Tim-Drake0/Flight-Computer/README.md

# Flight-Computer
Download and open bom.html for interactive BOM.

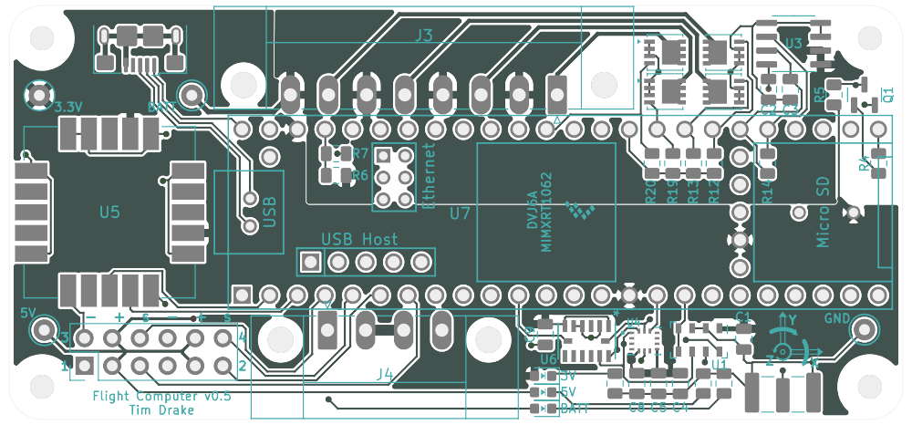
[picture p1: Pictures/v0.5.F.png]

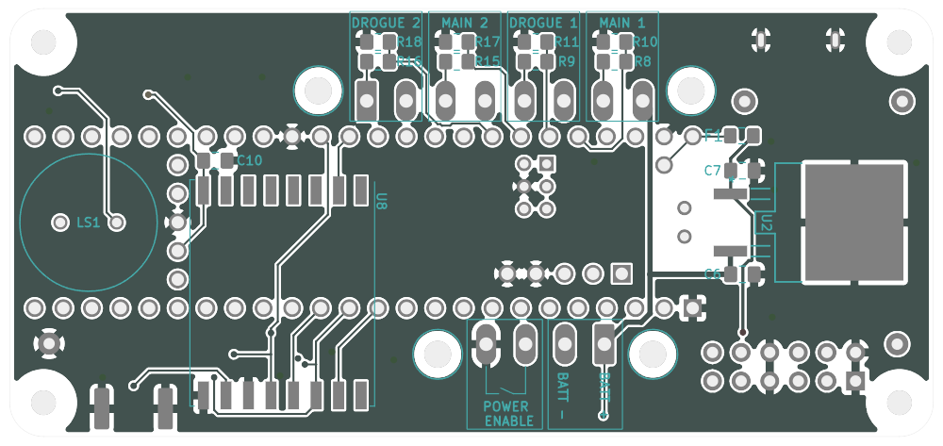
[picture p2: Pictures/v0.5.B.png]
