Tim-Drake0/Flight-Computer/v0.5.pdf

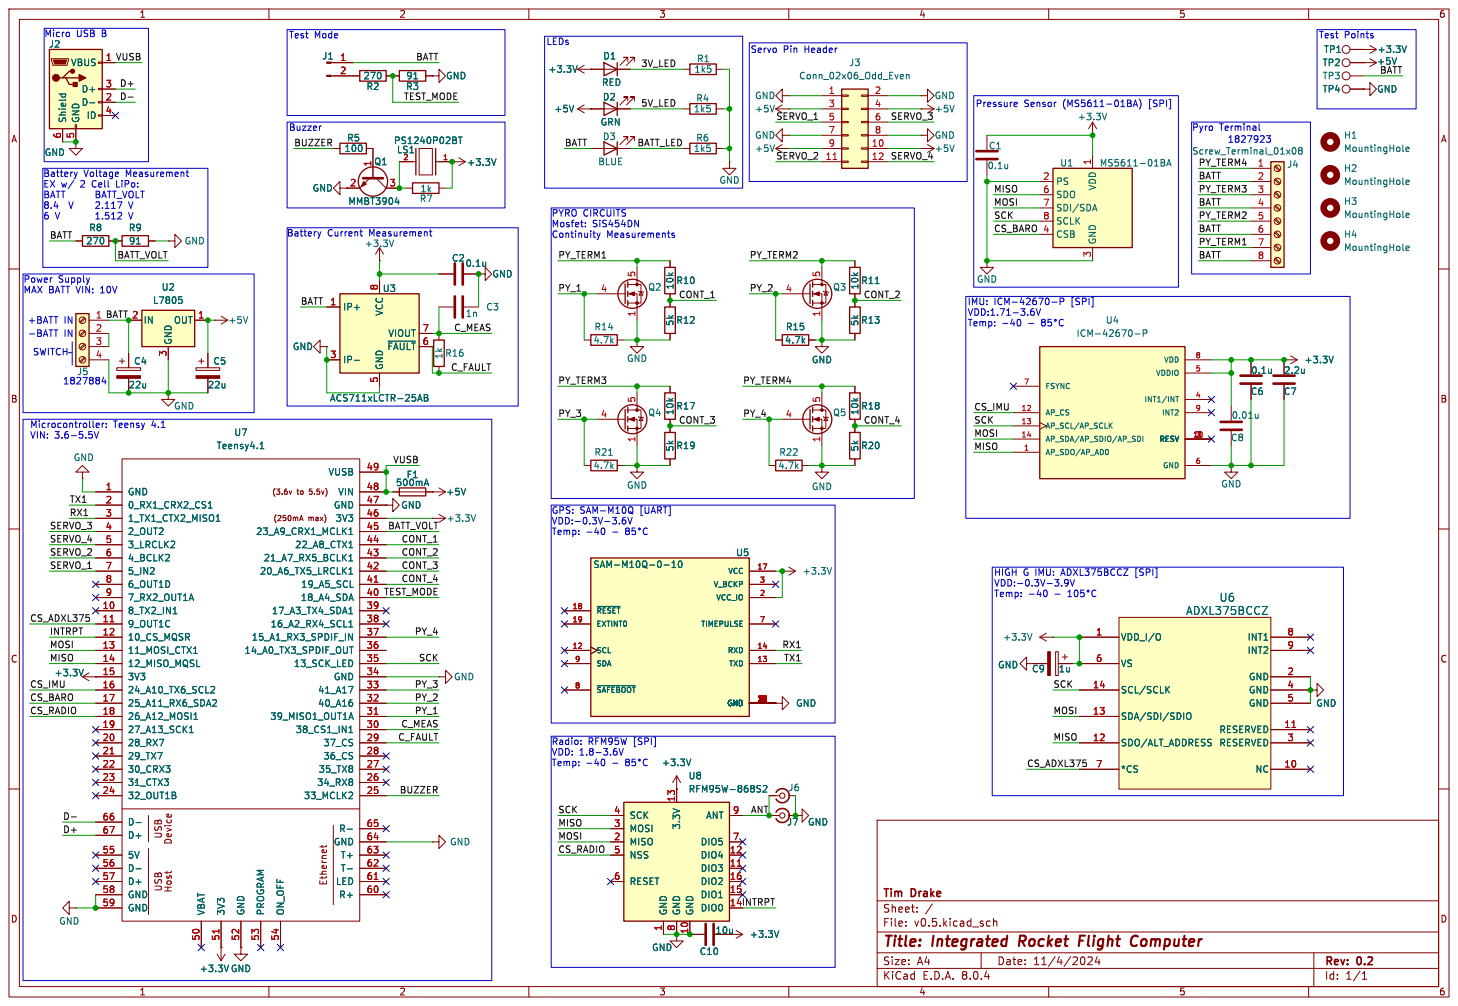
[picture p3: page 1]

Test Points PYRO CIRCUITS Mosfet: SiS454DN

3 CSB 4 SDO 6 SDI/SDA 7 SCLK 8 U1 MS5611-01BA GND

1827884 Power Supply MAX BATT VIN: 10V

1 GND 10 DIO3 11 DIO4 12 3.3V 13 DIO0 14 DIO1 15 DIO2 16 MISO 2 MOSI 3 SCK 4 NSS 5 RESET 6 DIO5 7 GND
