Tim-Drake0/Flight-Computer/v0.5.kicad_pcb

## KiCad design v0.5.kicad_pcb (2024-11-10)

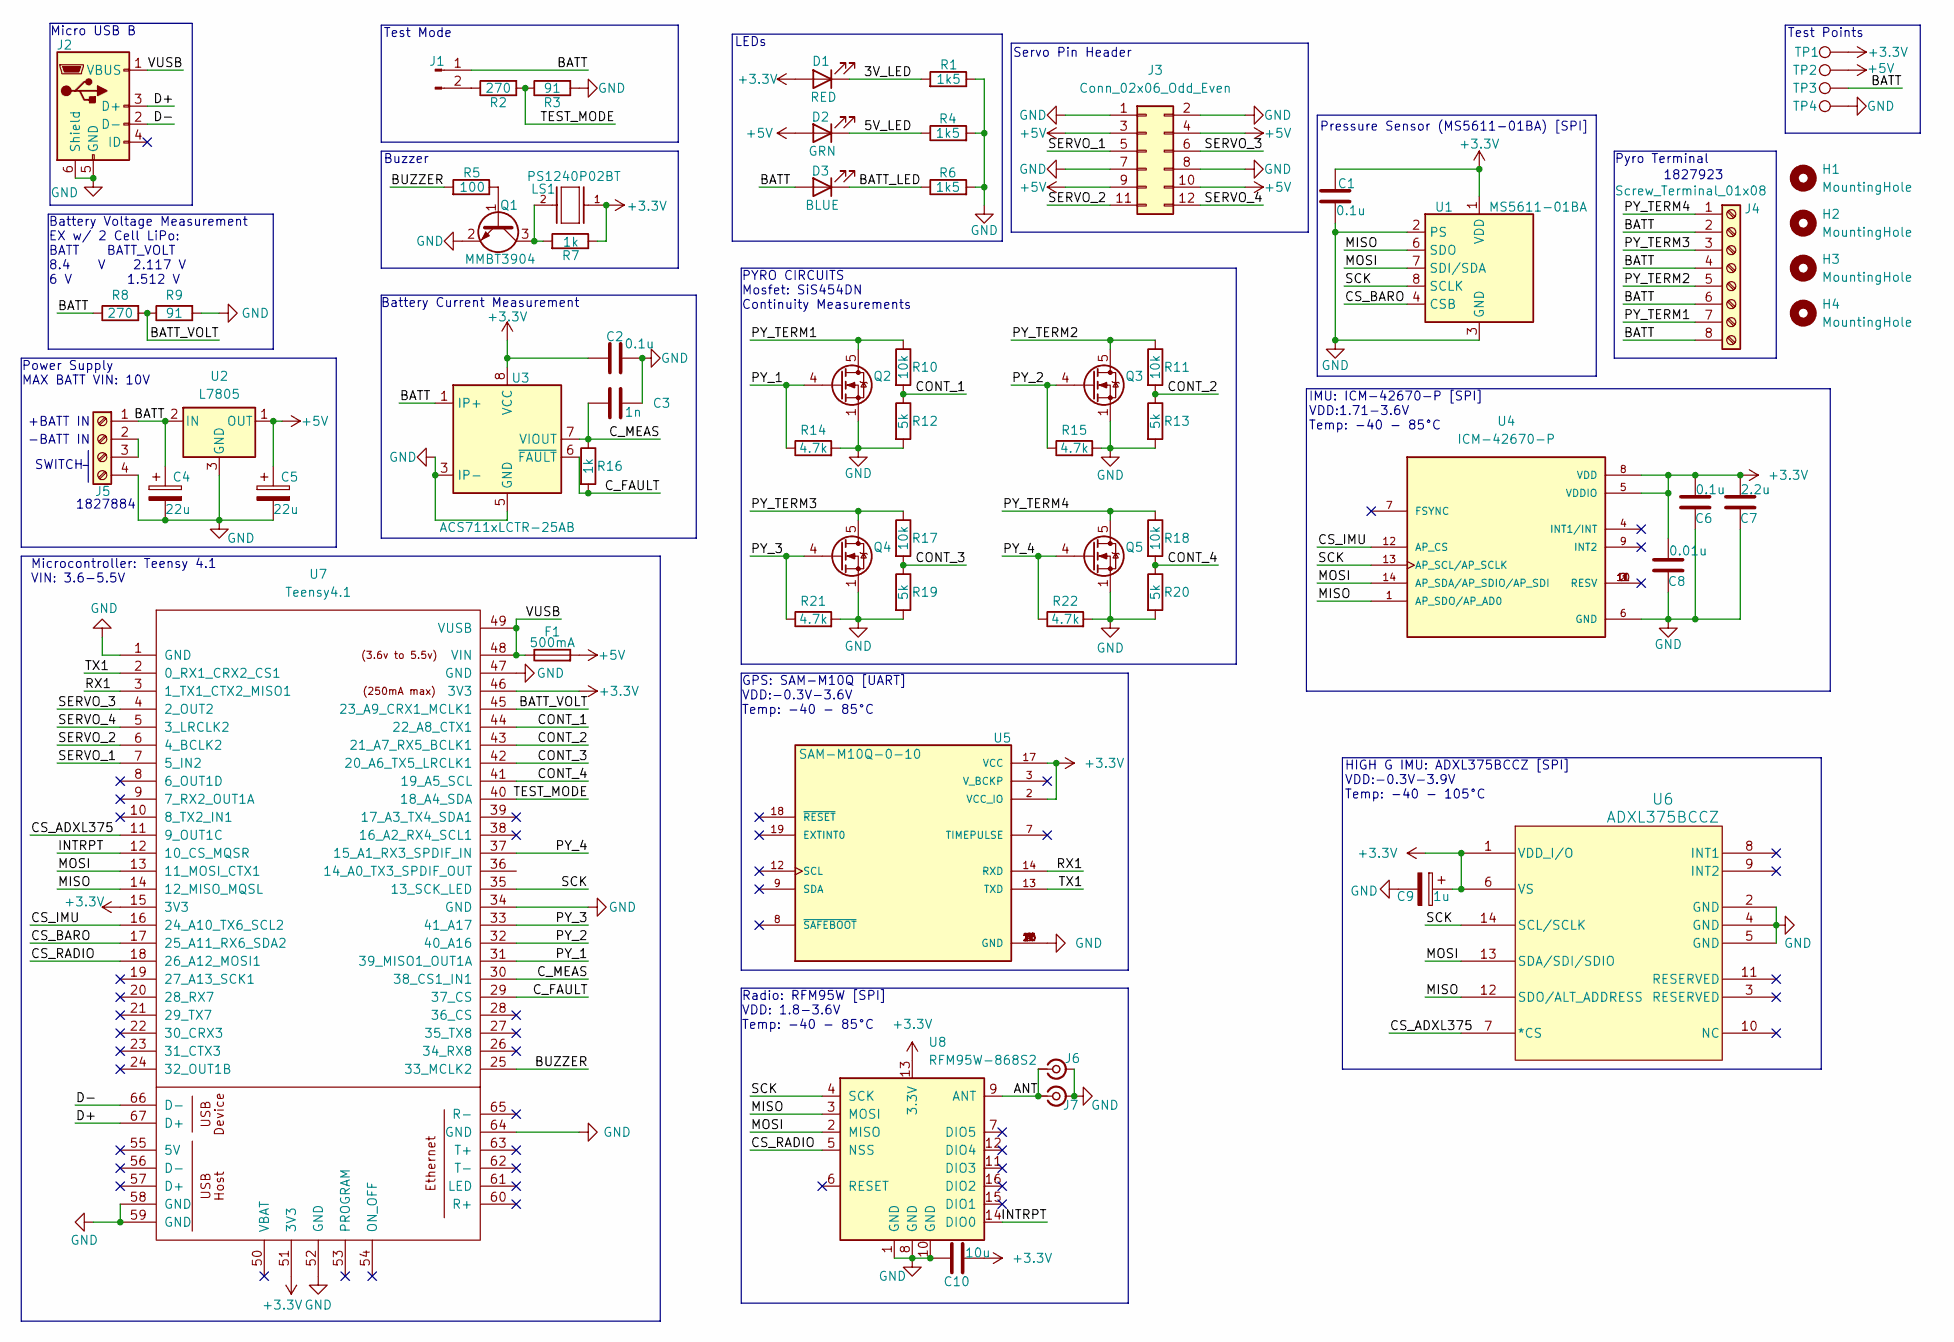
[picture p4: schematic v0.5.kicad_sch, Integrated Rocket Flight Computer]

Parts:
C1, C2, C6: 0.1u; C_0805_2012Metric; DigiKey CL21B104KBCNNNC
C3: 1n; C_0805_2012Metric; DigiKey CL21B102KCANNNC
C4, C5: 22u; C_0805_2012Metric; DigiKey TLJN226M010R3800
C7: 2.2u; C_0805_2012Metric; DigiKey CL21B225KPFNNNE
C8: 0.01u; C_0805_2012Metric; DigiKey CL21B103KBANNNC
C9: 1u; C_0805_2012Metric; DigiKey TAJR105K010RNJ
C10: 10u; C_0805_2012Metric_Pad1.18x1.45mm_HandSolder; DigiKey CL21A106KOQNNNE
D1: RED; LED_0603_1608Metric; DigiKey 150060RS75000
D2: GRN; LED_0603_1608Metric; DigiKey 150060GS75000
D3: BLUE; LED_0603_1608Metric; DigiKey 150060BS75000
F1: 500mA; Fuse_0805_2012Metric_Pad1.15x1.40mm_HandSolder; DigiKey F0805B0R50FSTR
H1, H2, H3, H4: MountingHole; MountingHole_2.2mm_M2
J1: Conn_01x02_Pin; PinHeader_1x02_P1.27mm_Horizontal; DigiKey M50-3930242, HMSC-G
J2: USB_B_Micro; USB_Micro-B_Amphenol_10118193-0001LF_Horizontal; DigiKey 10118193-0001LF
J3: Conn_02x06_Odd_Even; PinHeader_2x06_P2.54mm_Vertical; DigiKey PH2-12-UA
J4: Screw_Terminal_01x08; PhoenixContact_MC_1,5_8-GF-3.5_1x08_P3.50mm_Horizontal_Thre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
J5: Screw_Terminal_01x04; PhoenixContact_MC_1,5_4-GF-3.5_1x04_P3.50mm_Horizontal_Thre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
J6: Conn_Coaxial_Small; U.FL_Hirose_U.FL-R-SMT-1_Vertical
J7: Conn_Coaxial_Small; SMA_Samtec_SMA-J-P-H-ST-EM1_EdgeMount
LS1: PS1240P02BT; XDCR_PS1240P02BT; DigiKey PS1240P02BT
Q1: MMBT3904; SOT-23; DigiKey MMBT3904-7-F
Q2, Q3, Q4, Q5: SiS454DN; Vishay_PowerPAK_1212-8_Single; DigiKey SIS454DN-T1-GE3
R1, R4: 1k5; R_0805_2012Metric
R2, R8: 270; R_0805_2012Metric; DigiKey RC0805JR-07270RL
R3, R9: 91; R_0805_2012Metric; DigiKey RC0805FR-0791RL
R5: 100; R_0805_2012Metric; DigiKey RC0805FR-07100RL
R6: 1k5; R_0805_2012Metric; DigiKey RC0805FR-071K5L
R7, R16: 1k; R_0805_2012Metric; DigiKey RC0805FR-071KL
R10, R11, R17, R18: 10k; R_0805_2012Metric_Pad1.20x1.40mm_HandSolder; DigiKey ERJ-6GEYJ103V
R12, R13, R19, R20: 5k; R_0805_2012Metric_Pad1.20x1.40mm_HandSolder; DigiKey CRCW08055K00JNTA
R14, R15, R21, R22: 4.7k; R_0805_2012Metric; DigiKey CRCW08054K70FKEAC
TP1, TP2, TP3, TP4: TestPoint; TestPoint_Keystone_5000-5004_Miniature; DigiKey 5001
U1: MS5611-01BA; LGA-8_3x5mm_P1.25mm; DigiKey MS5611-01BA
U2: L7805; D2PAK_STM; DigiKey L7805ABD2T-TR
U3: ACS711xLCTR-25AB; SOIC-8_3.9x4.9mm_P1.27mm; DigiKey ACS711KLCTR-25AB-T
U4: ICM-42670-P; XDCR_ICM-42670-P; PARTREV 1.1; DigiKey_Part_Number 1428-ICM-42670-PTR-ND
U5: SAM-M10Q-0-10; ublox_SAM-M8Q_HandSolder; PARTREV R07; DigiKey SAM-M10Q-00B
U6: ADXL375BCCZ; LGA_CC-14-1_ADI; DigiKey ADXL375BCCZ
U7: Teensy4.1; Teensy41
U8: RFM95W-868S2; HOPERF_RFM9XW_SMD

Connections:
+3.3V: C1.1, C2.1, C6.2, C7.2, C8.2, C9.1, C10.1, D1.2 (A), LS1.1, R7.1, TP1.1, U1.1 (VDD), U3.8 (VCC), U4.5 (VDDIO), U4.8 (VDD), U5.2 (VCC_IO), U5.17 (VCC), U6.1 (VDD_I/O), U6.6 (VS), U7.15 (3V3), U7.46 (3V3), U7.51 (3V3), U8.13 (3.3V)
+5V: C5.1, D2.2 (A), F1.2, J3.3, J3.4, J3.9, J3.10, TP2.1, U2.1 (OUT)
/3V_LED: D1.1 (K), R1.2
/5V_LED: D2.1 (K), R4.1
/ANT: J6.1 (In), J7.1 (In), U8.9 (ANT)
/BATT: C4.1, D3.2 (A), J1.1, J4.2, J4.4, J4.6, J4.8, J5.1, R8.1, TP3.1, U2.2 (IN), U3.1 (IP+), U3.2 (IP+)
/BATT_LED: D3.1 (K), R6.1
/BATT_VOLT: R8.2, R9.1, U7.45 (23_A9_CRX1_MCLK1)
/BUZZER: R5.2, U7.25 (33_MCLK2)
/CONT_1: R10.2, R12.1, U7.44 (22_A8_CTX1)
/CONT_2: R11.2, R13.1, U7.43 (21_A7_RX5_BCLK1)
/CONT_3: R17.2, R19.1, U7.42 (20_A6_TX5_LRCLK1)
/CONT_4: R18.2, R20.1, U7.41 (19_A5_SCL)
/CS_ADXL375: U6.7 (*CS), U7.11 (9_OUT1C)
/CS_BARO: U1.4 (CSB), U1.5 (CSB), U7.17 (25_A11_RX6_SDA2)
/CS_IMU: U4.12 (AP_CS), U7.16 (24_A10_TX6_SCL2)
/CS_RADIO: U7.18 (26_A12_MOSI1), U8.5 (NSS)
/C_FAULT: R16.2, U3.6 (~FAULT), U7.29 (37_CS)
/C_MEAS: C3.1, R16.1, U3.7 (VIOUT), U7.30 (38_CS1_IN1)
/D+: J2.3 (D+), U7.67 (D+)
/D-: J2.2 (D-), U7.66 (D-)
/INTRPT: U7.12 (10_CS_MQSR), U8.14 (DIO0)
/MISO: U1.6 (SDO), U4.1 (AP_SDO/AP_AD0), U6.12 (SDO/ALT_ADDRESS), U7.14 (12_MISO_MQSL), U8.3 (MOSI)
/MOSI: U1.7 (SDI/SDA), U4.14 (AP_SDA/AP_SDIO/AP_SDI), U6.13 (SDA/SDI/SDIO), U7.13 (11_MOSI_CTX1), U8.2 (MISO)
/PY_1: Q2.4 (G), R14.1, U7.31 (39_MISO1_OUT1A)
/PY_2: Q3.4 (G), R15.1, U7.32 (40_A16)
/PY_3: Q4.4 (G), R21.1, U7.33 (41_A17)
/PY_4: Q5.4 (G), R22.1, U7.37 (15_A1_RX3_SPDIF_IN)
/PY_TERM1: J4.7, Q2.5 (D), R10.1
/PY_TERM2: J4.5, Q3.5 (D), R11.1
/PY_TERM3: J4.3, Q4.5 (D), R17.1
/PY_TERM4: J4.1, Q5.5 (D), R18.1
/RX1: U5.14 (RXD), U7.3 (1_TX1_CTX2_MISO1)
/SCK: U1.8 (SCLK), U4.13 (AP_SCL/AP_SCLK), U6.14 (SCL/SCLK), U7.35 (13_SCK_LED), U8.4 (SCK)
/SERVO_1: J3.5, U7.7 (5_IN2)
/SERVO_2: J3.11, U7.6 (4_BCLK2)
/SERVO_3: J3.6, U7.4 (2_OUT2)
/SERVO_4: J3.12, U7.5 (3_LRCLK2)
/TEST_MODE: R2.2, R3.1, U7.40 (18_A4_SDA)
/TX1: U5.13 (TXD), U7.2 (0_RX1_CRX2_CS1)
/VUSB: F1.1, J2.1 (VBUS), U7.48 (VIN), U7.49 (VUSB)
GND: C1.2, C2.2, C3.2, C4.2, C5.2, C6.1, C7.1, C8.1, C9.2, C10.2, J2.5 (GND), J2.6 (Shield), J3.1, J3.2, J3.7, J3.8, J5.4, J6.2 (Ext), J7.2 (Ext), Q1.2 (E), Q2.1 (S), Q2.2 (S), Q2.3 (S), Q3.1 (S), Q3.2 (S), Q3.3 (S), Q4.1 (S), Q4.2 (S), Q4.3 (S), Q5.1 (S), Q5.2 (S), Q5.3 (S), R1.1, R3.2, R4.2, R6.2, R9.2, R12.2, R13.2, R14.2, R15.2, R19.2, R20.2, R21.2, R22.2, TP4.1, U1.2 (PS), U1.3 (GND), U2.3 (GND), U3.3 (IP-), U3.4 (IP-), U3.5 (GND), U4.6 (GND), U5.1 (GND), U5.4 (GND), U5.5 (GND), U5.6 (GND), U5.10 (GND), U5.11 (GND), U5.15 (GND), U5.16 (GND), U5.20 (GND), U6.2 (GND), U6.4 (GND), U6.5 (GND), U7.1 (GND), U7.34 (GND), U7.47 (GND), U7.52 (GND), U7.58 (GND), U7.59 (GND), U7.64 (GND), U8.1 (GND), U8.8 (GND), U8.10 (GND)
unnamed: J1.2, R2.1
unnamed: J5.2, J5.3
unnamed: Q1.1 (B), R5.1
unnamed: LS1.2, Q1.3 (C), R7.2

Notes on the sheet:
-BATT IN
Power Supply MAX BATT VIN: 10V
1827923
LEDs
Pyro Terminal
IMU: ICM-42670-P [SPI] VDD:1.71-3.6V Temp: -40 - 85°C
Microcontroller: Teensy 4.1 VIN: 3.6-5.5V
GPS: SAM-M10Q [UART] VDD:-0.3V-3.6V Temp: -40 - 85°C
Servo Pin Header
1827884
Battery Current Measurement
SWITCH
Test Mode
HIGH G IMU: ADXL375BCCZ [SPI] VDD:-0.3V-3.9V Temp: -40 - 105°C
Test Points
+BATT IN
Radio: RFM95W [SPI] VDD: 1.8-3.6V Temp: -40 - 85°C
Micro USB B
Pressure Sensor (MS5611-01BA) [SPI]
Battery Voltage Measurement EX w/ 2 Cell LiPo: BATT BATT_VOLT 8.4 V 2.117 V 6 V 1.512 V
PYRO CIRCUITS Mosfet: SiS454DN Continuity Measurements
Buzzer

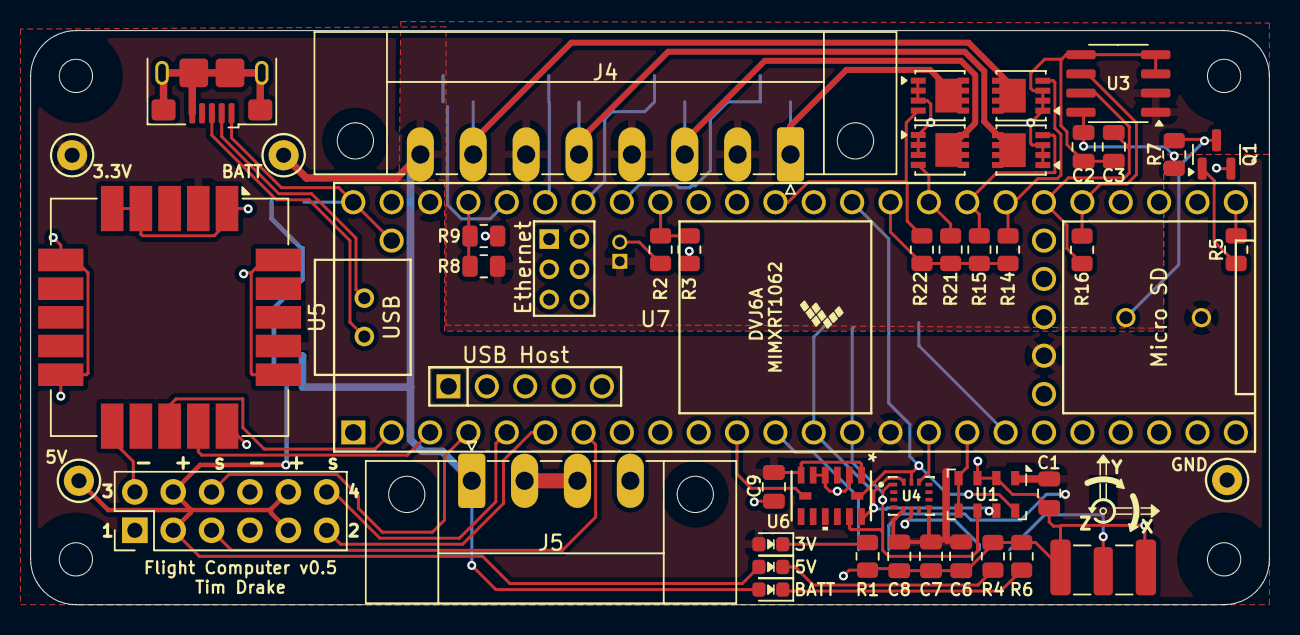
[picture p5: board v0.5.kicad_pcb from above]

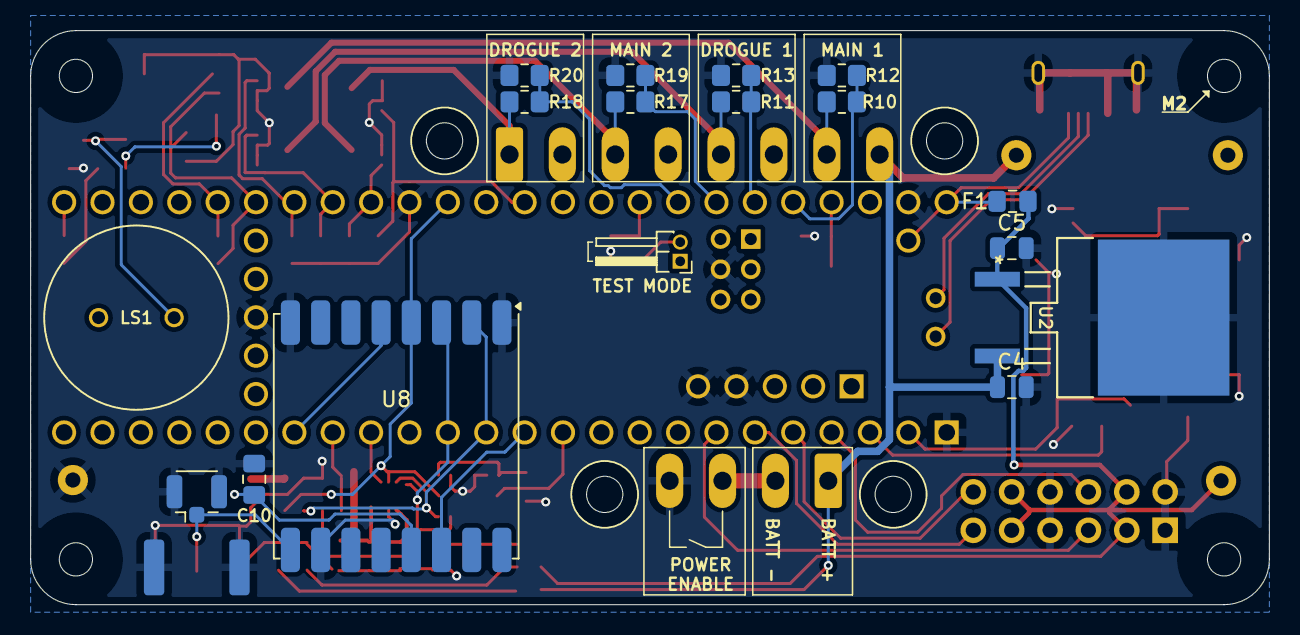
[picture p6: board v0.5.kicad_pcb from below]

Board: 2 copper layers, 82.0 x 38.0 mm, 65 parts (17 on the bottom side), 46 nets.
