Tim-Drake0/Flight-Computer/(commit log)

2024-11-10 Added test pin headers. Updated BOM
    [v0.5.kicad_pcb, v0.5.kicad_sch]
2024-11-10 Updated BOM
2024-11-10 Using RFM95W radio now instead of RFM69W.
    [v0.5.kicad_pcb, v0.5.kicad_sch]
2024-11-10 Ready to buy
    [v0.5.kicad_pcb]
2024-11-10 Add gerber files
    [v0.5.kicad_pcb]
2024-11-10 Updated gerber files
    [v0.5-B_Cu.gbr, v0.5-B_Mask.gbr, v0.5-B_Paste.gbr, v0.5-B_Silkscreen.gbr, v0.5-Edge_Cuts.gbr, v0.5-F_Cu.gbr, v0.5-F_Mask.gbr, v0.5-F_Paste.gbr]
